kirtanmgajjar/Design-and-Development-of-5-DoF-Robotic-arm/README.md

# Design-and-Development-of-5-DoF-Robotic-arm
This was a final year project. Report Also uploaded.
