kirtanmgajjar/Design-and-Development-of-5-DoF-Robotic-arm/(commit log)

2022-09-03 Arduino code
2022-09-03 Update and rename Arduino.ino to Arduino, Python, App Inventor files
2022-09-03 Create For 3d Printing
